SolarBoatTwente/SlavePowerSensor/Software/README.md

#Software requirements

To build/upload: Arduino IDE
To develop: Eclipse IDE + sloeber plugin
