SolarBoatTwente/SlavePowerSensor/(list of files, drawings)

Other design files:
Hardware/SPS/Design/P1A/Genasun_Wattmeter.PrjPcb
Hardware/SPS/Design/P1A/PCB.PcbDoc
Hardware/SPS/Design/P1A/Schematic.SchDoc
Hardware/SPS/Design/P1B/Genasun_Wattmeter.PrjPcb
Hardware/SPS/Design/P1B/PCB.PcbDoc
Hardware/SPS/Design/P1B/Schematic.SchDoc
