SolarBoatTwente/SlavePowerSensor/(commit log)

2019-03-14 Creation Added preliminary folder structure Added SBT docs
    [Genasun_Wattmeter.PrjPcb, PCB.PcbDoc, Schematic.SchDoc]
2019-03-14 Started EPS document
    [Genasun_Wattmeter.PrjPcb, PCB.PcbDoc, Schematic.SchDoc]
2019-04-12 Fixing bug and finalizing code
    Fixing I2C write bug
    Removing PIN_LED_RELAY
    Checheking for devices (should be %2 instead of %1)
    [MPPT_test_master.ino, SBT_SPS.ino, SBT_SPSI.ino]
2019-05-20 Adding Comments about how devices work
